Fizan-Feroz/ESP-FC-custom/pcb/v2/drc_report.txt

** Drc report for esp-fc-v2.kicad_pcb **
** Created on 2026-11-04T15:46:17 **
** Report includes: Errors, Warnings **

** Found 74 DRC violations **
[lib_footprint_issues]: The current configuration does not include the footprint library 'Resistor_SMD'
    Local override; warning
    @(107.5000 mm, 110.6000 mm): Footprint R9
[lib_footprint_issues]: The current configuration does not include the footprint library 'LED_SMD'
    Local override; warning
    @(107.5000 mm, 105.0000 mm): Footprint D3
[lib_footprint_issues]: The current configuration does not include the footprint library 'Resistor_SMD'
    Local override; warning
    @(107.5000 mm, 106.9000 mm): Footprint R8
[lib_footprint_issues]: The current configuration does not include the footprint library 'Connector_USB'
    Local override; warning
    @(86.3000 mm, 96.0000 mm): Footprint J2
[lib_footprint_issues]: The current configuration does not include the footprint library 'MountingHole'
    Local override; warning
    @(84.7500 mm, 115.2500 mm): Footprint H4
[lib_footprint_issues]: The current configuration does not include the footprint library 'Inductor_SMD'
    Local override; warning
    @(114.6000 mm, 91.4000 mm): Footprint L1
[lib_footprint_issues]: The current configuration does not include the footprint library 'Capacitor_SMD'
    Local override; warning
    @(115.9000 mm, 105.6000 mm): Footprint C2
[lib_footprint_issues]: The current configuration does not include the footprint library 'Diode_SMD'
    Local override; warning
    @(92.2000 mm, 108.0000 mm): Footprint D1
[lib_footprint_issues]: The current configuration does not include the footprint library 'Capacitor_SMD'
    Local override; warning
    @(89.7500 mm, 87.0000 mm): Footprint C11
[lib_footprint_issues]: The current configuration does not include the footprint library 'Package_TO_SOT_SMD'
    Local override; warning
    @(100.9000 mm, 107.4000 mm): Footprint U4
[lib_footprint_issues]: The current configuration does not include the footprint library 'Connector_JST'
    Local override; warning
    @(100.0000 mm, 114.5000 mm): Footprint J1
[lib_footprint_issues]: The current configuration does not include the footprint library 'TestPoint'
    Local override; warning
    @(85.0000 mm, 109.9000 mm): Footprint TP2
[lib_footprint_issues]: The current configuration does not include the footprint library 'Package_SO'
    Local override; warning
    @(114.6000 mm, 98.6000 mm): Footprint U1
[lib_footprint_issues]: The current configuration does not include the footprint library 'RF_Module'
    Local override; warning
    @(101.5000 mm, 93.2000 mm): Footprint U5
[lib_footprint_issues]: The current configuration does not include the footprint library 'Capacitor_SMD'
    Local override; warning
    @(89.7500 mm, 83.7500 mm): Footprint C12
[lib_footprint_issues]: The current configuration does not include the footprint library 'MountingHole'
    Local override; warning
    @(115.2500 mm, 84.7500 mm): Footprint H2
[lib_footprint_issues]: The current configuration does not include the footprint library 'MountingHole'
    Local override; warning
    @(84.7500 mm, 84.7500 mm): Footprint H1
[lib_footprint_issues]: The current configuration does not include the footprint library 'TestPoint'
    Local override; warning
    @(85.0000 mm, 106.0000 mm): Footprint TP1
[lib_footprint_issues]: The current configuration does not include the footprint library 'LED_SMD'
    Local override; warning
    @(107.5000 mm, 108.8000 mm): Footprint D4
[lib_footprint_issues]: The current configuration does not include the footprint library 'MountingHole'
    Local override; warning
    @(115.2500 mm, 115.2500 mm): Footprint H3
[lib_footprint_issues]: The current configuration does not include the footprint library 'Capacitor_SMD'
    Local override; warning
    @(112.9000 mm, 105.6000 mm): Footprint C1
[lib_footprint_issues]: The current configuration does not include the footprint library 'Capacitor_SMD'
    Local override; warning
    @(112.9000 mm, 91.2000 mm): Footprint C6
[lib_footprint_issues]: The current configuration does not include the footprint library 'Package_TO_SOT_SMD'
    Local override; warning
    @(109.6000 mm, 106.0000 mm): Footprint Q3
[lib_footprint_issues]: The current configuration does not include the footprint library 'Package_LGA'
    Local override; warning
    @(104.8000 mm, 99.0000 mm): Footprint U6
[lib_footprint_issues]: The current configuration does not include the footprint library 'TestPoint'
    Local override; warning
    @(116.3000 mm, 109.6000 mm): Footprint TP4
[lib_footprint_issues]: The current configuration does not include the footprint library 'Capacitor_SMD'
    Local override; warning
    @(100.0000 mm, 102.0000 mm): Footprint C17
[lib_footprint_issues]: The current configuration does not include the footprint library 'Resistor_SMD'
    Local override; warning
    @(109.8000 mm, 103.0000 mm): Footprint R2
[lib_footprint_issues]: The current configuration does not include the footprint library 'Package_TO_SOT_SMD'
    Local override; warning
    @(93.0000 mm, 104.5000 mm): Footprint Q1
[lib_footprint_issues]: The current configuration does not include the footprint library 'Resistor_SMD'
    Local override; warning
    @(109.4000 mm, 89.7000 mm): Footprint R12
[lib_footprint_issues]: The current configuration does not include the footprint library 'Diode_SMD'
    Local override; warning
    @(114.6000 mm, 106.6000 mm): Footprint D5
[lib_footprint_issues]: The current configuration does not include the footprint library 'Capacitor_SMD'
    Local override; warning
    @(102.3000 mm, 108.5000 mm): Footprint C9
[lib_footprint_issues]: The current configuration does not include the footprint library 'Package_TO_SOT_SMD'
    Local override; warning
    @(88.5000 mm, 103.2000 mm): Footprint U2
[lib_footprint_issues]: The current configuration does not include the footprint library 'Resistor_SMD'
    Local override; warning
    @(106.3000 mm, 111.0000 mm): Footprint R16
[lib_footprint_issues]: The current configuration does not include the footprint library 'Capacitor_SMD'
    Local override; warning
    @(114.6000 mm, 103.5000 mm): Footprint C3
[lib_footprint_issues]: The current configuration does not include the footprint library 'Resistor_SMD'
    Local override; warning
    @(103.2000 mm, 89.7000 mm): Footprint R10
[lib_footprint_issues]: The current configuration does not include the footprint library 'Inductor_SMD'
    Local override; warning
    @(107.4000 mm, 102.4000 mm): Footprint FB1
[lib_footprint_issues]: The current configuration does not include the footprint library 'Resistor_SMD'
    Local override; warning
    @(93.0000 mm, 107.6000 mm): Footprint R5
[lib_footprint_issues]: The current configuration does not include the footprint library 'Capacitor_SMD'
    Local override; warning
    @(104.8000 mm, 96.3500 mm): Footprint C14
[lib_footprint_issues]: The current configuration does not include the footprint library 'Resistor_SMD'
    Local override; warning
    @(84.0000 mm, 102.5000 mm): Footprint R3
[lib_footprint_issues]: The current configuration does not include the footprint library 'Button_Switch_SMD'
    Local override; warning
    @(101.0000 mm, 115.5000 mm): Footprint SW2
[lib_footprint_issues]: The current configuration does not include the footprint library 'Resistor_SMD'
    Local override; warning
    @(84.0000 mm, 106.4000 mm): Footprint R4
[lib_footprint_issues]: The current configuration does not include the footprint library 'Capacitor_SMD'
    Local override; warning
    @(102.6000 mm, 104.0000 mm): Footprint C18
[lib_footprint_issues]: The current configuration does not include the footprint library 'Capacitor_SMD'
    Local override; warning
    @(106.0000 mm, 108.5000 mm): Footprint C10
[lib_footprint_issues]: The current configuration does not include the footprint library 'Capacitor_SMD'
    Local override; warning
    @(107.4000 mm, 99.0000 mm): Footprint C16
[lib_footprint_issues]: The current configuration does not include the footprint library 'TestPoint'
    Local override; warning
    @(113.5000 mm, 109.6000 mm): Footprint TP3
[lib_footprint_issues]: The current configuration does not include the footprint library 'Resistor_SMD'
    Local override; warning
    @(100.0000 mm, 96.0000 mm): Footprint R17
[lib_footprint_issues]: The current configuration does not include the footprint library 'Capacitor_SMD'
    Local override; warning
    @(96.6000 mm, 89.7000 mm): Footprint C8
[lib_footprint_issues]: The current configuration does not include the footprint library 'Resistor_SMD'
    Local override; warning
    @(109.6000 mm, 109.0000 mm): Footprint R15
[lib_footprint_issues]: The current configuration does not include the footprint library 'Package_SO'
    Local override; warning
    @(94.5000 mm, 97.5000 mm): Footprint U3
[lib_footprint_issues]: The current configuration does not include the footprint library 'Diode_SMD'
    Local override; warning
    @(88.3000 mm, 106.6000 mm): Footprint D2
[lib_footprint_issues]: The current configuration does not include the footprint library 'Package_TO_SOT_SMD'
    Local override; warning
    @(97.2000 mm, 104.5000 mm): Footprint Q2
[lib_footprint_issues]: The current configuration does not include the footprint library 'Capacitor_SMD'
    Local override; warning
    @(93.4000 mm, 89.7000 mm): Footprint C13
[lib_footprint_issues]: The current configuration does not include the footprint library 'Button_Switch_SMD'
    Local override; warning
    @(95.0000 mm, 115.5000 mm): Footprint SW1
[lib_footprint_issues]: The current configuration does not include the footprint library 'Capacitor_SMD'
    Local override; warning
    @(104.8000 mm, 101.6500 mm): Footprint C15
[lib_footprint_issues]: The current configuration does not include the footprint library 'Resistor_SMD'
    Local override; warning
    @(100.0000 mm, 98.0000 mm): Footprint R13
[lib_footprint_issues]: The current configuration does not include the footprint library 'Connector_JST'
    Local override; warning
    @(105.0000 mm, 85.6000 mm): Footprint J3
[lib_footprint_issues]: The current configuration does not include the footprint library 'Capacitor_SMD'
    Local override; warning
    @(115.9000 mm, 91.2000 mm): Footprint C7
[lib_footprint_issues]: The current configuration does not include the footprint library 'Capacitor_SMD'
    Local override; warning
    @(109.8000 mm, 95.0000 mm): Footprint C5
[lib_footprint_issues]: The current configuration does not include the footprint library 'Resistor_SMD'
    Local override; warning
    @(100.0000 mm, 100.0000 mm): Footprint R14
[lib_footprint_issues]: The current configuration does not include the footprint library 'Resistor_SMD'
    Local override; warning
    @(106.3000 mm, 89.7000 mm): Footprint R11
[lib_footprint_issues]: The current configuration does not include the footprint library 'Capacitor_SMD'
    Local override; warning
    @(109.8000 mm, 97.0000 mm): Footprint C4
[lib_footprint_issues]: The current configuration does not include the footprint library 'Resistor_SMD'
    Local override; warning
    @(90.4000 mm, 89.7000 mm): Footprint R7
[lib_footprint_issues]: The current configuration does not include the footprint library 'TestPoint'
    Local override; warning
    @(109.6000 mm, 112.6000 mm): Footprint TP5
[lib_footprint_issues]: The current configuration does not include the footprint library 'Resistor_SMD'
    Local override; warning
    @(109.8000 mm, 101.0000 mm): Footprint R1
[lib_footprint_issues]: The current configuration does not include the footprint library 'Resistor_SMD'
    Local override; warning
    @(97.2000 mm, 107.6000 mm): Footprint R6
[lib_footprint_issues]: The current configuration does not include the footprint library 'Connector_JST'
    Local override; warning
    @(94.2000 mm, 85.6000 mm): Footprint J4
[silk_overlap]: Silkscreen clearance
    Rule: board setup constraints silk; warning
    @(100.0000 mm, 110.5200 mm): Reference field of J1
    @(99.0500 mm, 110.8100 mm): Segment of U4 on F.Silkscreen
[silk_over_copper]: Silkscreen clipped by solder mask
    Local override; warning
    @(100.9000 mm, 102.9000 mm): Reference field of U4
    @(100.8650 mm, 102.5500 mm): Pad 19 [<no net>] of U5 on F.Cu
[silk_over_copper]: Silkscreen clipped by solder mask
    Local override; warning
    @(111.1000 mm, 98.6000 mm): Reference field of U1
    @(110.2500 mm, 98.7600 mm): Pad 27 [UART2_RX] of U5 on F.Cu
[silk_over_copper]: Silkscreen clipped by solder mask
    Local override; warning
    @(91.9450 mm, 96.0000 mm): Reference field of J2
    @(92.7500 mm, 96.2200 mm): Pad 10 [M2] of U5 on F.Cu
[silk_over_copper]: Silkscreen clipped by solder mask
    Local override; warning
    @(105.0000 mm, 89.5800 mm): Reference field of J3
    @(104.0250 mm, 89.7000 mm): Pad 1 [+3V3] of R10 on B.Cu
[silk_over_copper]: Silkscreen clipped by solder mask
    Local override; warning
    @(105.0000 mm, 89.5800 mm): Reference field of J3
    @(105.4750 mm, 89.7000 mm): Pad 2 [I2C_SDA] of R11 on B.Cu
[silk_over_copper]: Silkscreen clipped by solder mask
    Local override; warning
    @(94.2000 mm, 89.5800 mm): Reference field of J4
    @(94.1750 mm, 89.7000 mm): Pad 1 [EN] of C13 on B.Cu
[silk_over_copper]: Silkscreen clipped by solder mask
    Local override; warning
    @(88.5000 mm, 100.8000 mm): Reference field of U2
    @(89.4300 mm, 100.3200 mm): PTH pad SH [GND] of J2

** Found 0 unconnected pads **

** Found 0 Footprint errors **

** Ignored checks **
    - Footprint has no courtyard defined
    - Track endpoint not centered on via
    - Tuning profile track geometries
    - Footprint doesn't match symbol's footprint filters
    - Footprint component type doesn't match footprint pads

** End of Report **
