Fizan-Feroz/ESP-FC-custom/pcb/v2/erc_report.txt

ERC report (2026-11-04T15:46:17, Encoding UTF8)
Report includes: Errors, Warnings

***** Sheet /
[footprint_link_issues]: The current configuration does not include the footprint library 'Inductor_SMD'
    ; warning
    @(30.48 mm, 74.93 mm): Symbol L1 [L]
[lib_symbol_issues]: The current configuration does not include the symbol library 'Device'
    ; warning
    @(30.48 mm, 74.93 mm): Symbol L1 [L]
[footprint_link_issues]: The current configuration does not include the footprint library 'Resistor_SMD'
    ; warning
    @(30.48 mm, 190.50 mm): Symbol R6 [R]
[lib_symbol_issues]: The current configuration does not include the symbol library 'Device'
    ; warning
    @(30.48 mm, 190.50 mm): Symbol R6 [R]
[footprint_link_issues]: The current configuration does not include the footprint library 'Package_TO_SOT_SMD'
    ; warning
    @(30.48 mm, 270.51 mm): Symbol U4 [AP7361C-33E]
[lib_symbol_issues]: The current configuration does not include the symbol library 'Regulator_Linear'
    ; warning
    @(30.48 mm, 270.51 mm): Symbol U4 [AP7361C-33E]
[footprint_link_issues]: The current configuration does not include the footprint library 'LED_SMD'
    ; warning
    @(30.48 mm, 304.80 mm): Symbol D3 [LED]
[lib_symbol_issues]: The current configuration does not include the symbol library 'Device'
    ; warning
    @(30.48 mm, 304.80 mm): Symbol D3 [LED]
[footprint_link_issues]: The current configuration does not include the footprint library 'Capacitor_SMD'
    ; warning
    @(30.48 mm, 420.37 mm): Symbol C18 [C]
[lib_symbol_issues]: The current configuration does not include the symbol library 'Device'
    ; warning
    @(30.48 mm, 420.37 mm): Symbol C18 [C]
[lib_symbol_issues]: The current configuration does not include the symbol library 'power'
    ; warning
    @(30.48 mm, 454.66 mm): Symbol #FLG03 [PWR_FLAG]
[footprint_link_issues]: The current configuration does not include the footprint library 'Connector_JST'
    ; warning
    @(49.53 mm, 59.69 mm): Symbol J1 [Conn_01x08_MountingPin]
[lib_symbol_issues]: The current configuration does not include the symbol library 'Connector_Generic_MountingPin'
    ; warning
    @(49.53 mm, 59.69 mm): Symbol J1 [Conn_01x08_MountingPin]
[footprint_link_issues]: The current configuration does not include the footprint library 'Connector_USB'
    ; warning
    @(49.53 mm, 175.26 mm): Symbol J2 [USB_C_Receptacle_USB2.0_16P]
[lib_symbol_issues]: The current configuration does not include the symbol library 'Connector'
    ; warning
    @(49.53 mm, 175.26 mm): Symbol J2 [USB_C_Receptacle_USB2.0_16P]
[footprint_link_issues]: The current configuration does not include the footprint library 'Package_LGA'
    ; warning
    @(49.53 mm, 405.13 mm): Symbol U6 [ICM-42688-P]
[footprint_link_issues]: The current configuration does not include the footprint library 'Resistor_SMD'
    ; warning
    @(59.69 mm, 74.93 mm): Symbol R1 [R]
[lib_symbol_issues]: The current configuration does not include the symbol library 'Device'
    ; warning
    @(59.69 mm, 74.93 mm): Symbol R1 [R]
[footprint_link_issues]: The current configuration does not include the footprint library 'Capacitor_SMD'
    ; warning
    @(59.69 mm, 270.51 mm): Symbol C9 [C]
[lib_symbol_issues]: The current configuration does not include the symbol library 'Device'
    ; warning
    @(59.69 mm, 270.51 mm): Symbol C9 [C]
[footprint_link_issues]: The current configuration does not include the footprint library 'Resistor_SMD'
    ; warning
    @(59.69 mm, 304.80 mm): Symbol R9 [R]
[lib_symbol_issues]: The current configuration does not include the symbol library 'Device'
    ; warning
    @(59.69 mm, 304.80 mm): Symbol R9 [R]
[footprint_link_issues]: The current configuration does not include the footprint library 'Package_TO_SOT_SMD'
    ; warning
    @(59.69 mm, 420.37 mm): Symbol Q3 [2N7002]
[lib_symbol_issues]: The current configuration does not include the symbol library 'Transistor_FET'
    ; warning
    @(59.69 mm, 420.37 mm): Symbol Q3 [2N7002]
[lib_symbol_issues]: The current configuration does not include the symbol library 'power'
    ; warning
    @(59.69 mm, 454.66 mm): Symbol #FLG04 [PWR_FLAG]
[footprint_link_issues]: The current configuration does not include the footprint library 'Resistor_SMD'
    ; warning
    @(90.17 mm, 74.93 mm): Symbol R2 [R]
[lib_symbol_issues]: The current configuration does not include the symbol library 'Device'
    ; warning
    @(90.17 mm, 74.93 mm): Symbol R2 [R]
[footprint_link_issues]: The current configuration does not include the footprint library 'Capacitor_SMD'
    ; warning
    @(90.17 mm, 270.51 mm): Symbol C10 [C]
[lib_symbol_issues]: The current configuration does not include the symbol library 'Device'
    ; warning
    @(90.17 mm, 270.51 mm): Symbol C10 [C]
[footprint_link_issues]: The current configuration does not include the footprint library 'LED_SMD'
    ; warning
    @(90.17 mm, 304.80 mm): Symbol D4 [LED]
[lib_symbol_issues]: The current configuration does not include the symbol library 'Device'
    ; warning
    @(90.17 mm, 304.80 mm): Symbol D4 [LED]
[footprint_link_issues]: The current configuration does not include the footprint library 'Resistor_SMD'
    ; warning
    @(90.17 mm, 420.37 mm): Symbol R15 [R]
[lib_symbol_issues]: The current configuration does not include the symbol library 'Device'
    ; warning
    @(90.17 mm, 420.37 mm): Symbol R15 [R]
[footprint_link_issues]: The current configuration does not include the footprint library 'MountingHole'
    ; warning
    @(90.17 mm, 454.66 mm): Symbol H1 [MountingHole]
[lib_symbol_issues]: The current configuration does not include the symbol library 'Mechanical'
    ; warning
    @(90.17 mm, 454.66 mm): Symbol H1 [MountingHole]
[footprint_link_issues]: The current configuration does not include the footprint library 'TestPoint'
    ; warning
    @(100.33 mm, 39.37 mm): Symbol TP1 [TestPoint]
[lib_symbol_issues]: The current configuration does not include the symbol library 'Connector'
    ; warning
    @(100.33 mm, 39.37 mm): Symbol TP1 [TestPoint]
[footprint_link_issues]: The current configuration does not include the footprint library 'Resistor_SMD'
    ; warning
    @(100.33 mm, 154.94 mm): Symbol R3 [R]
[lib_symbol_issues]: The current configuration does not include the symbol library 'Device'
    ; warning
    @(100.33 mm, 154.94 mm): Symbol R3 [R]
[footprint_link_issues]: The current configuration does not include the footprint library 'Inductor_SMD'
    ; warning
    @(100.33 mm, 384.81 mm): Symbol FB1 [FerriteBead]
[lib_symbol_issues]: The current configuration does not include the symbol library 'Device'
    ; warning
    @(100.33 mm, 384.81 mm): Symbol FB1 [FerriteBead]
[footprint_link_issues]: The current configuration does not include the footprint library 'Capacitor_SMD'
    ; warning
    @(119.38 mm, 74.93 mm): Symbol C6 [C]
[lib_symbol_issues]: The current configuration does not include the symbol library 'Device'
    ; warning
    @(119.38 mm, 74.93 mm): Symbol C6 [C]
[footprint_link_issues]: The current configuration does not include the footprint library 'Capacitor_SMD'
    ; warning
    @(119.38 mm, 270.51 mm): Symbol C11 [C]
[lib_symbol_issues]: The current configuration does not include the symbol library 'Device'
    ; warning
    @(119.38 mm, 270.51 mm): Symbol C11 [C]
[footprint_link_issues]: The current configuration does not include the footprint library 'Diode_SMD'
    ; warning
    @(119.38 mm, 420.37 mm): Symbol D5 [D]
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
    ; warning
    @(180.34 mm, 454.66 mm): Symbol H4 [MountingHole]
[lib_symbol_issues]: The current configuration does not include the symbol library 'Mechanical'
    ; warning
    @(180.34 mm, 454.66 mm): Symbol H4 [MountingHole]
[footprint_link_issues]: The current configuration does not include the footprint library 'Capacitor_SMD'
    ; warning
    @(190.50 mm, 39.37 mm): Symbol C1 [C]
[lib_symbol_issues]: The current configuration does not include the symbol library 'Device'
    ; warning
    @(190.50 mm, 39.37 mm): Symbol C1 [C]
[footprint_link_issues]: The current configuration does not include the footprint library 'Diode_SMD'
    ; warning
    @(190.50 mm, 154.94 mm): Symbol D2 [D_Schottky]
[lib_symbol_issues]: The current configuration does not include the symbol library 'Device'
    ; warning
    @(190.50 mm, 154.94 mm): Symbol D2 [D_Schottky]
[footprint_link_issues]: The current configuration does not include the footprint library 'Capacitor_SMD'
    ; warning
    @(190.50 mm, 384.81 mm): Symbol C16 [C]
[lib_symbol_issues]: The current configuration does not include the symbol library 'Device'
    ; warning
    @(190.50 mm, 384.81 mm): Symbol C16 [C]
[footprint_link_issues]: The current configuration does not include the footprint library 'RF_Module'
    ; warning
    @(199.39 mm, 289.56 mm): Symbol U5 [ESP32-WROOM-32UE]
[lib_symbol_issues]: The current configuration does not include the symbol library 'RF_Module'
    ; warning
    @(199.39 mm, 289.56 mm): Symbol U5 [ESP32-WROOM-32UE]
[footprint_link_issues]: The current configuration does not include the footprint library 'Resistor_SMD'
    ; warning
    @(209.55 mm, 420.37 mm): Symbol R16 [R]
[lib_symbol_issues]: The current configuration does not include the symbol library 'Device'
    ; warning
    @(209.55 mm, 420.37 mm): Symbol R16 [R]
[footprint_link_issues]: The current configuration does not include the footprint library 'Capacitor_SMD'
    ; warning
    @(219.71 mm, 39.37 mm): Symbol C2 [C]
[lib_symbol_issues]: The current configuration does not include the symbol library 'Device'
    ; warning
    @(219.71 mm, 39.37 mm): Symbol C2 [C]
[footprint_link_issues]: The current configuration does not include the footprint library 'Resistor_SMD'
    ; warning
    @(219.71 mm, 384.81 mm): Symbol R10 [R]
[lib_symbol_issues]: The current configuration does not include the symbol library 'Device'
    ; warning
    @(219.71 mm, 384.81 mm): Symbol R10 [R]
[footprint_link_issues]: The current configuration does not include the footprint library 'Package_SO'
    ; warning
    @(240.03 mm, 175.26 mm): Symbol U3 [CH340C]
[lib_symbol_issues]: The current configuration does not include the symbol library 'Interface_USB'
    ; warning
    @(240.03 mm, 175.26 mm): Symbol U3 [CH340C]
[footprint_link_issues]: The current configuration does not include the footprint library 'TestPoint'
    ; warning
    @(240.03 mm, 420.37 mm): Symbol TP5 [TestPoint]
[lib_symbol_issues]: The current configuration does not include the symbol library 'Connector'
    ; warning
    @(240.03 mm, 420.37 mm): Symbol TP5 [TestPoint]
[footprint_link_issues]: The current configuration does not include the footprint library 'Capacitor_SMD'
    ; warning
    @(250.19 mm, 39.37 mm): Symbol C3 [C]
[lib_symbol_issues]: The current configuration does not include the symbol library 'Device'
    ; warning
    @(250.19 mm, 39.37 mm): Symbol C3 [C]
[footprint_link_issues]: The current configuration does not include the footprint library 'Resistor_SMD'
    ; warning
    @(250.19 mm, 270.51 mm): Symbol R7 [R]
[lib_symbol_issues]: The current configuration does not include the symbol library 'Device'
    ; warning
    @(250.19 mm, 270.51 mm): Symbol R7 [R]
[footprint_link_issues]: The current configuration does not include the footprint library 'Resistor_SMD'
    ; warning
    @(250.19 mm, 384.81 mm): Symbol R11 [R]
[lib_symbol_issues]: The current configuration does not include the symbol library 'Device'
    ; warning
    @(250.19 mm, 384.81 mm): Symbol R11 [R]
[footprint_link_issues]: The current configuration does not include the footprint library 'Connector_JST'
    ; warning
    @(270.51 mm, 420.37 mm): Symbol J3 [Conn_01x04_MountingPin]
[lib_symbol_issues]: The current configuration does not include the symbol library 'Connector_Generic_MountingPin'
    ; warning
    @(270.51 mm, 420.37 mm): Symbol J3 [Conn_01x04_MountingPin]
[footprint_link_issues]: The current configuration does not include the footprint library 'Capacitor_SMD'
    ; warning
    @(279.40 mm, 270.51 mm): Symbol C13 [C]
[lib_symbol_issues]: The current configuration does not include the symbol library 'Device'
    ; warning
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
    ; warning
    @(369.57 mm, 270.51 mm): Symbol R8 [R]
[footprint_link_issues]: The current configuration does not include the footprint library 'Capacitor_SMD'
    ; warning
    @(369.57 mm, 384.81 mm): Symbol C17 [C]
[lib_symbol_issues]: The current configuration does not include the symbol library 'Device'
    ; warning
    @(369.57 mm, 384.81 mm): Symbol C17 [C]
[footprint_link_issues]: The current configuration does not include the footprint library 'Capacitor_SMD'
    ; warning
    @(379.73 mm, 39.37 mm): Symbol C5 [C]
[lib_symbol_issues]: The current configuration does not include the symbol library 'Device'
    ; warning
    @(379.73 mm, 39.37 mm): Symbol C5 [C]
[footprint_link_issues]: The current configuration does not include the footprint library 'Package_TO_SOT_SMD'
    ; warning
    @(379.73 mm, 154.94 mm): Symbol Q2 [MMBT3904]
[lib_symbol_issues]: The current configuration does not include the symbol library 'Transistor_BJT'
    ; warning
    @(379.73 mm, 154.94 mm): Symbol Q2 [MMBT3904]
[footprint_link_issues]: The current configuration does not include the footprint library 'Resistor_SMD'
    ; warning
    @(400.05 mm, 175.26 mm): Symbol R17 [R]
[lib_symbol_issues]: The current configuration does not include the symbol library 'Device'
    ; warning
    @(400.05 mm, 175.26 mm): Symbol R17 [R]
[lib_symbol_issues]: The current configuration does not include the symbol library 'power'
    ; warning
    @(430.53 mm, 175.26 mm): Symbol #FLG05 [PWR_FLAG]

 ** ERC messages: 136  Errors 0  Warnings 136

 ** Ignored checks:
    - Global label only appears once in the schematic
    - Four connection points are joined together
    - SPICE model issue
    - Assigned footprint doesn't match footprint filters
