Fizan-Feroz/ESP-FC-custom/pcb/esp32_fc_bottom_render.png

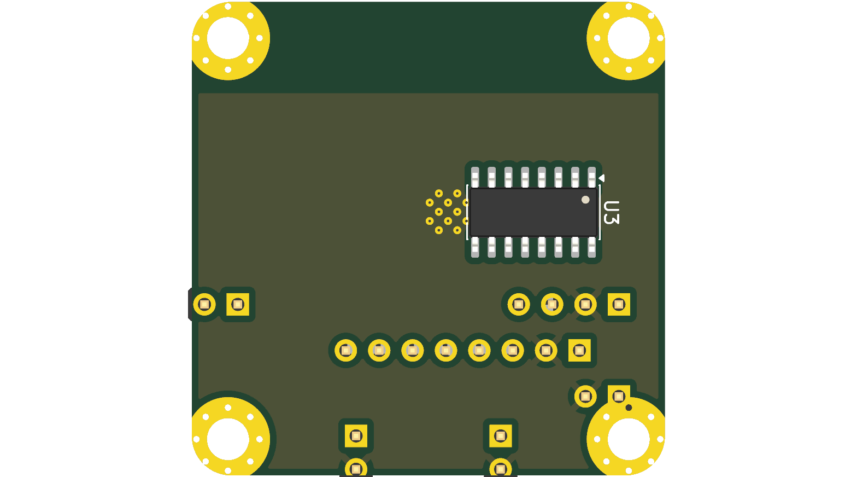
pcb/esp32_fc_bottom_render.png
