Fizan-Feroz/ESP-FC-custom/pcb/esp32_fc_top_render.png

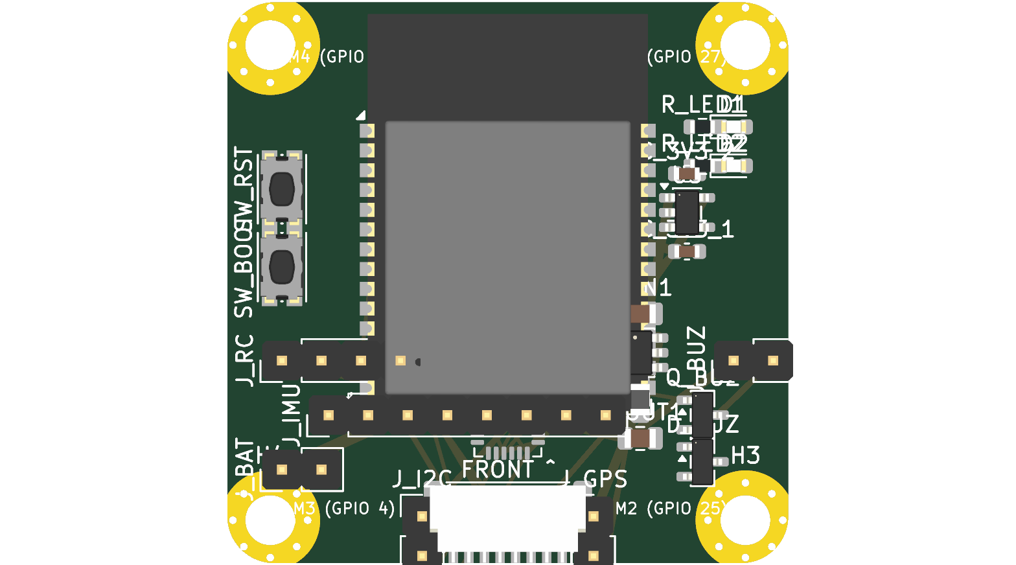
pcb/esp32_fc_top_render.png
