Fizan-Feroz/ESP-FC-custom/pcb/v2/v2_placement_top.png

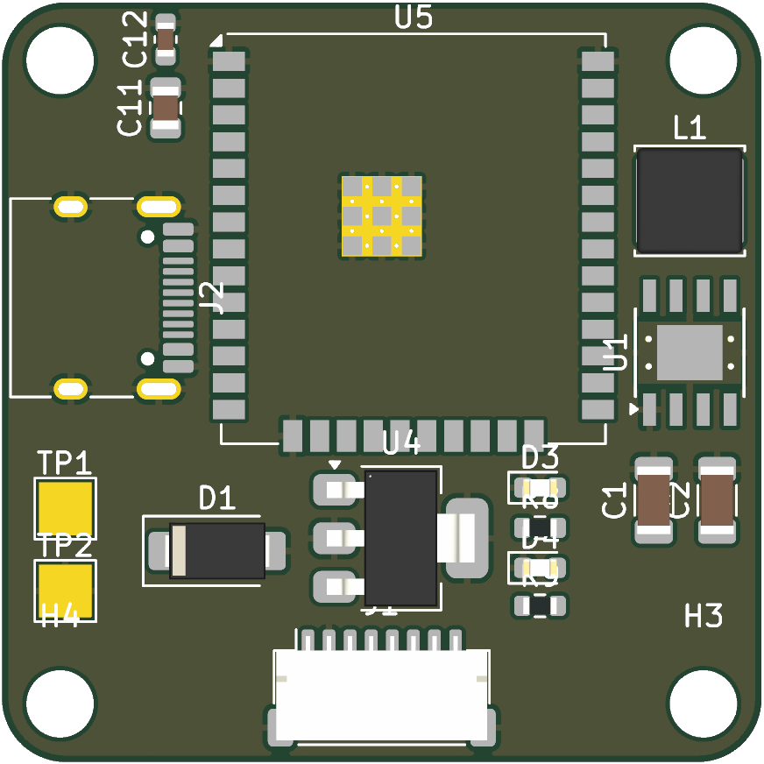
pcb/v2/v2_placement_top.png
