Fizan-Feroz/ESP-FC-custom/pcb/v2/esp-fc-v2.kicad_pcb

## KiCad design pcb/v2/esp-fc-v2.kicad_pcb (2026-11-04)

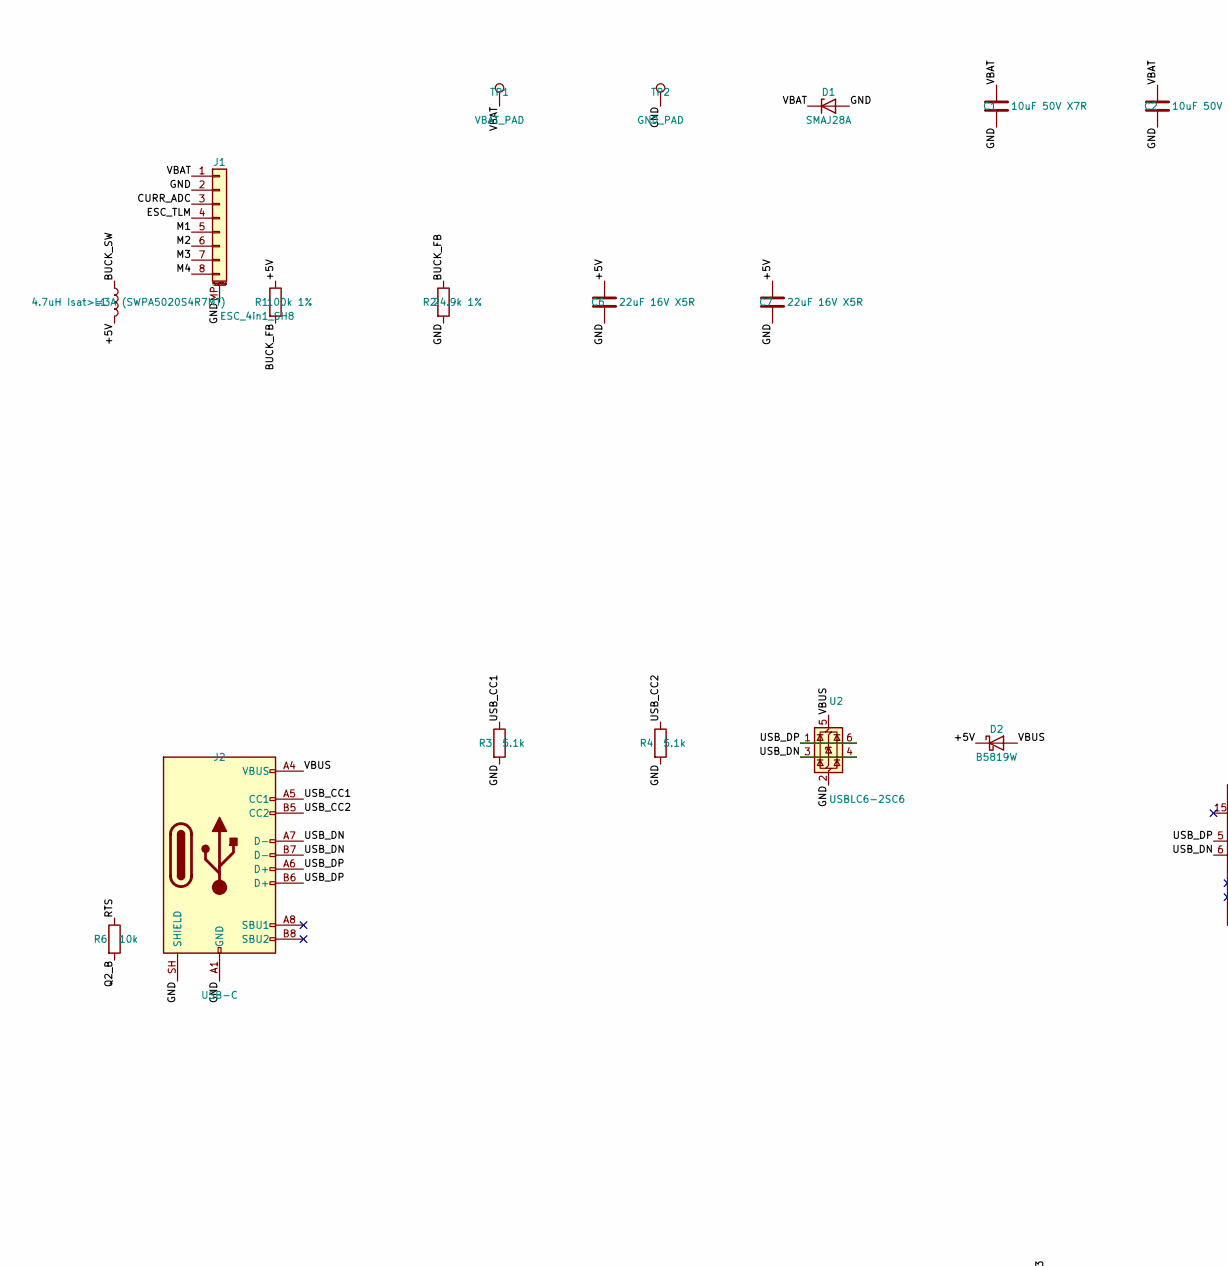
[picture p4: schematic esp-fc-v2.kicad_sch, part in row 1, column 1]

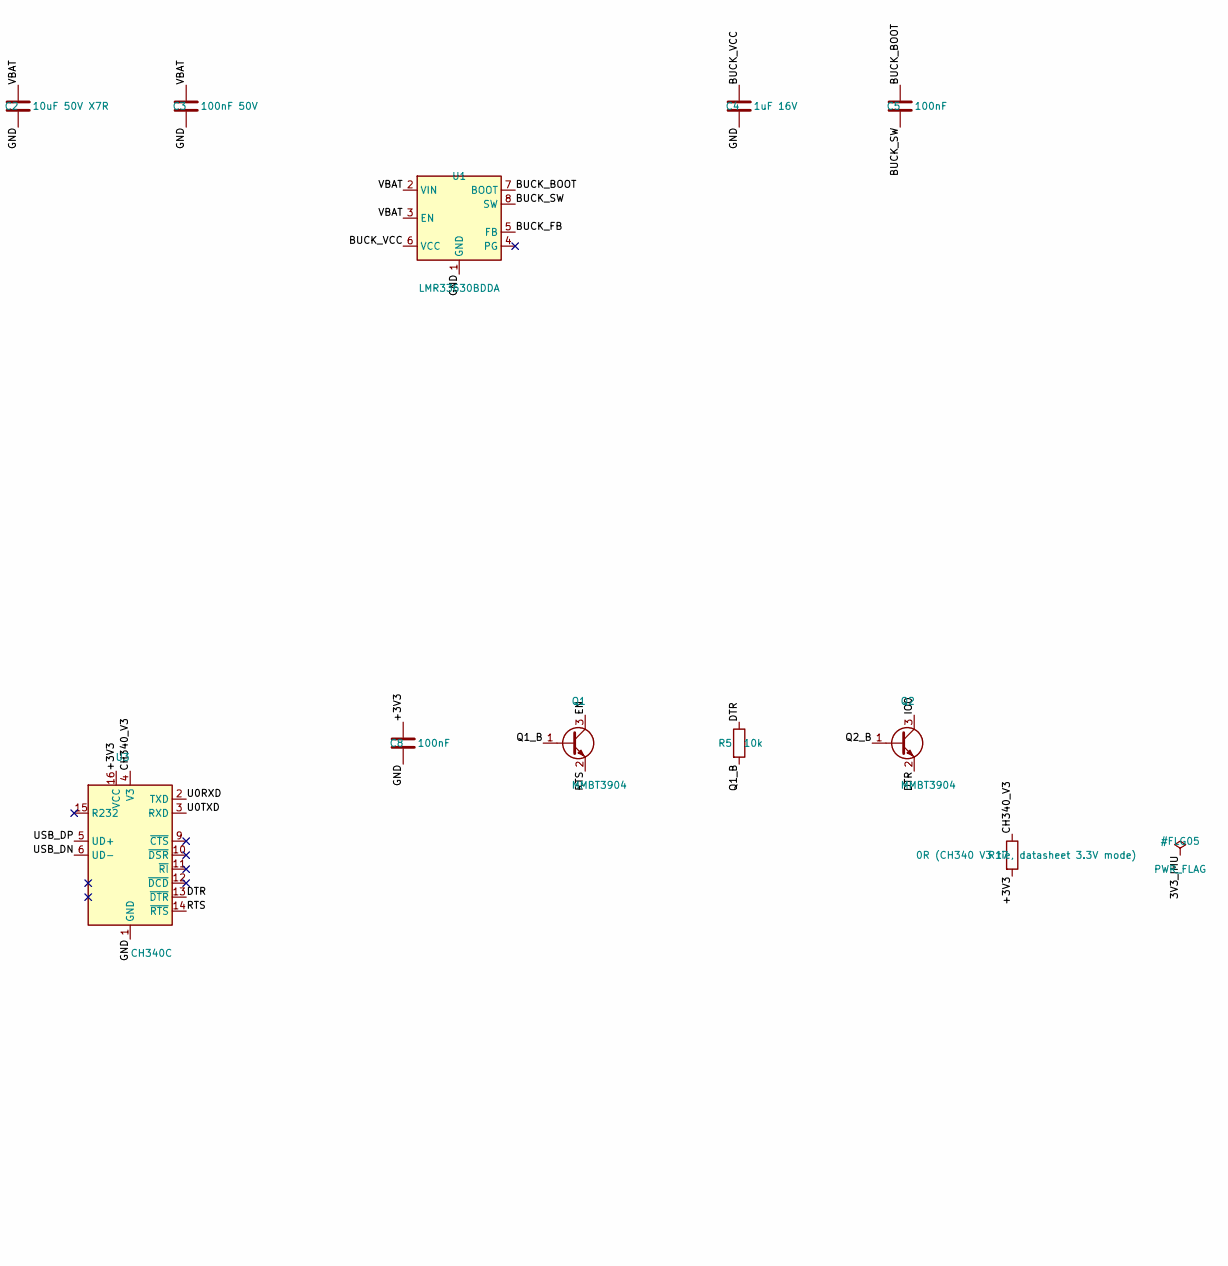
[picture p5: schematic esp-fc-v2.kicad_sch, part in row 1, column 2]

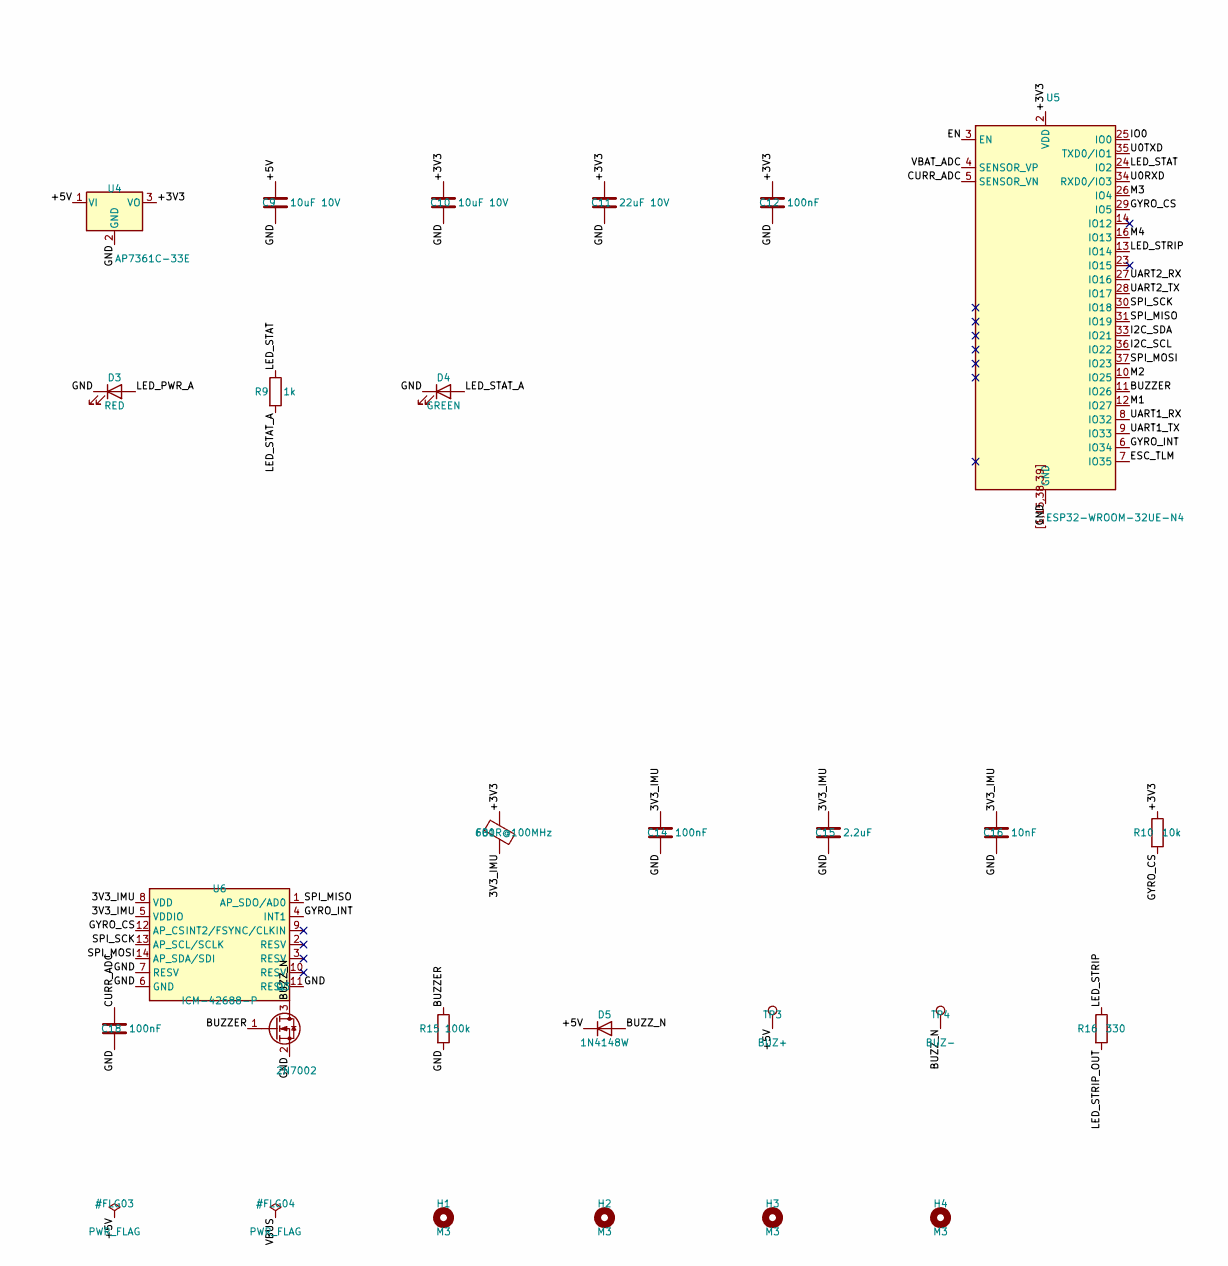
[picture p6: schematic esp-fc-v2.kicad_sch, part in row 2, column 1]

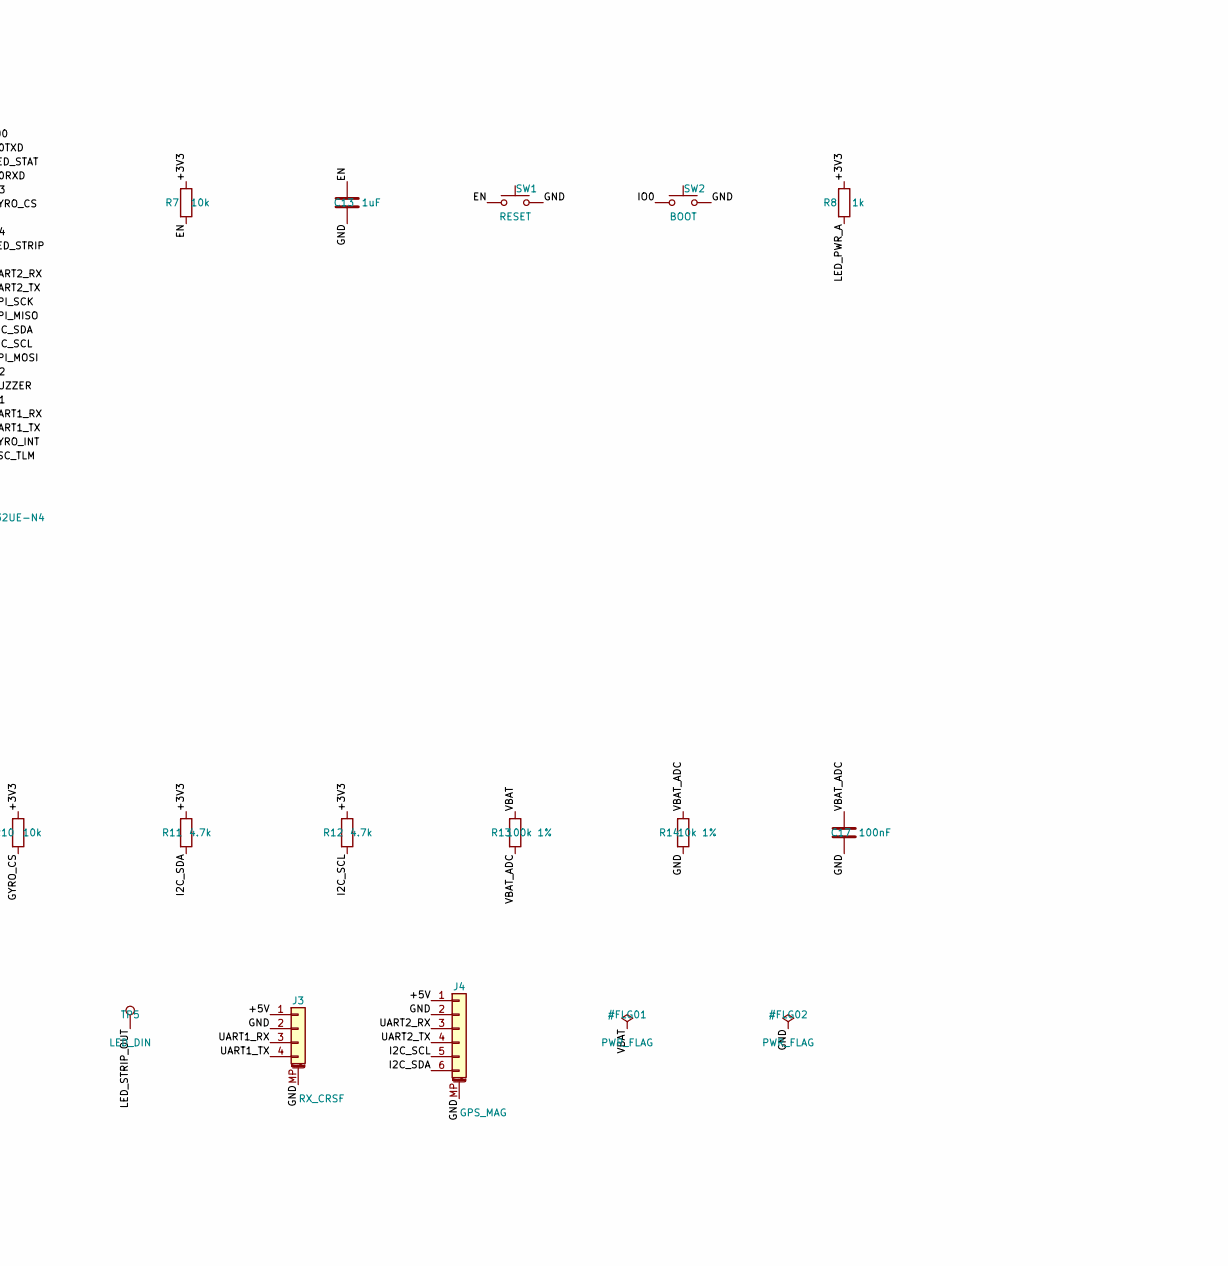
[picture p7: schematic esp-fc-v2.kicad_sch, part in row 2, column 2]

Parts:
C1, C2: 10uF 50V X7R; C_1206_3216Metric
C3: 100nF 50V; C_0603_1608Metric
C4: 1uF 16V; C_0603_1608Metric
C5, C8, C12, C14, C17, C18: 100nF; C_0603_1608Metric
C6, C7: 22uF 16V X5R; C_1206_3216Metric
C9, C10: 10uF 10V; C_0805_2012Metric
C11: 22uF 10V; C_0805_2012Metric
C13: 1uF; C_0603_1608Metric
C15: 2.2uF; C_0603_1608Metric
C16: 10nF; C_0603_1608Metric
D1: SMAJ28A; D_SMA
D2: B5819W; D_SOD-123
D3: RED; LED_0603_1608Metric
D4: GREEN; LED_0603_1608Metric
D5: 1N4148W; D_SOD-323
FB1: 600R@100MHz; L_0603_1608Metric
H1, H2, H3, H4: M3; MountingHole_3.2mm_M3
J1: ESC_4in1_SH8; JST_SH_SM08B-SRSS-TB_1x08-1MP_P1.00mm_Horizontal
J2: USB-C; USB_C_Receptacle_HRO_TYPE-C-31-M-12
J3: RX_CRSF; JST_SH_SM04B-SRSS-TB_1x04-1MP_P1.00mm_Horizontal
J4: GPS_MAG; JST_SH_SM06B-SRSS-TB_1x06-1MP_P1.00mm_Horizontal
L1: 4.7uH Isat>=3A (SWPA5020S4R7MT); L_Sunlord_SWPA5020S
Q1, Q2: MMBT3904; SOT-23
Q3: 2N7002; SOT-23
R1, R13: 100k 1%; R_0603_1608Metric
R2: 24.9k 1%; R_0603_1608Metric
R3, R4: 5.1k; R_0603_1608Metric
R5, R6, R7, R10: 10k; R_0603_1608Metric
R8, R9: 1k; R_0603_1608Metric
R11, R12: 4.7k; R_0603_1608Metric
R14: 10k 1%; R_0603_1608Metric
R15: 100k; R_0603_1608Metric
R16: 330; R_0603_1608Metric
R17: 0R (CH340 V3 tie, datasheet 3.3V mode); R_0603_1608Metric
SW1: RESET; SW_Push_1P1T_NO_CK_KMR2
SW2: BOOT; SW_Push_1P1T_NO_CK_KMR2
TP1: VBAT_PAD; TestPoint_Pad_2.5x2.5mm
TP2: GND_PAD; TestPoint_Pad_2.5x2.5mm
TP3: BUZ+; TestPoint_Pad_1.5x1.5mm
TP4: BUZ-; TestPoint_Pad_1.5x1.5mm
TP5: LED_DIN; TestPoint_Pad_1.5x1.5mm
U1: LMR33630BDDA; Texas_HSOP-8-1EP_3.9x4.9mm_P1.27mm_ThermalVias
U2: USBLC6-2SC6; SOT-23-6
U3: CH340C; SOIC-16_3.9x9.9mm_P1.27mm
U4: AP7361C-33E; SOT-223-3_TabPin2
U5: ESP32-WROOM-32UE-N4; ESP32-WROOM-32UE
U6: ICM-42688-P; LGA-14_3x2.5mm_P0.5mm_LayoutBorder3x4y

Connections:
3V3_IMU: C14.1, C15.1, C16.1, FB1.2, U6.5 (VDDIO), U6.8 (VDD)
+3V3: C8.1, C10.1, C11.1, C12.1, FB1.1, R7.1, R8.1, R10.1, R11.1, R12.1, R17.2, U3.16 (VCC), U4.3 (VO), U5.2 (VDD)
+5V: C6.1, C7.1, C9.1, D2.1 (K), D5.1 (K), J3.1, J4.1, L1.2, R1.1, TP3.1, U4.1 (VI)
BUCK_BOOT: C5.1, U1.7 (BOOT)
BUCK_FB: R1.2, R2.1, U1.5 (FB)
BUCK_SW: C5.2, L1.1, U1.8 (SW)
BUCK_VCC: C4.1, U1.6 (VCC)
BUZZER: Q3.1 (G), R15.1, U5.11 (IO26)
BUZZ_N: D5.2 (A), Q3.3 (D), TP4.1
CH340_V3: R17.1, U3.4 (V3)
CURR_ADC: C18.1, J1.3, U5.5 (SENSOR_VN)
DTR: Q2.2 (E), R5.1, U3.13 (~DTR)
EN: C13.1, Q1.3 (C), R7.2, SW1.1, U5.3 (EN)
ESC_TLM: J1.4, U5.7 (IO35)
GND: C1.2, C2.2, C3.2, C4.2, C6.2, C7.2, C8.2, C9.2, C10.2, C11.2, C12.2, C13.2, C14.2, C15.2, C16.2, C17.2, C18.2, D1.2 (A), D3.1 (K), D4.1 (K), J1.2, J1.MP (MountPin), J2.A1 (GND), J2.A12 (GND), J2.B1 (GND), J2.B12 (GND), J2.SH (SHIELD), J3.2, J3.MP (MountPin), J4.2, J4.MP (MountPin), Q3.2 (S), R2.2, R3.2, R4.2, R14.2, R15.2, SW1.2, SW2.2, TP2.1, U1.1 (GND), U1.9 (GND), U2.2 (GND), U3.1 (GND), U4.2 (GND), U5.1, U5.15, U5.38, U5.39, U5.[1,15,38,39] (GND), U6.6 (GND), U6.7 (RESV), U6.11 (RESV)
GYRO_CS: R10.2, U5.29 (IO5), U6.12 (AP_CS)
GYRO_INT: U5.6 (IO34), U6.4 (INT1)
I2C_SCL: J4.5, R12.2, U5.36 (IO22)
I2C_SDA: J4.6, R11.2, U5.33 (IO21)
IO0: Q2.3 (C), SW2.1, U5.25 (IO0)
LED_PWR_A: D3.2 (A), R8.2
LED_STAT: R9.1, U5.24 (IO2)
LED_STAT_A: D4.2 (A), R9.2
LED_STRIP: R16.1, U5.13 (IO14)
LED_STRIP_OUT: R16.2, TP5.1
M1: J1.5, U5.12 (IO27)
M2: J1.6, U5.10 (IO25)
M3: J1.7, U5.26 (IO4)
M4: J1.8, U5.16 (IO13)
Q1_B: Q1.1 (B), R5.2
Q2_B: Q2.1 (B), R6.2
RTS: Q1.2 (E), R6.1, U3.14 (~RTS)
SPI_MISO: U5.31 (IO19), U6.1 (AP_SDO/AD0)
SPI_MOSI: U5.37 (IO23), U6.14 (AP_SDA/SDI)
SPI_SCK: U5.30 (IO18), U6.13 (AP_SCL/SCLK)
U0RXD: U3.2 (TXD), U5.34 (RXD0/IO3)
U0TXD: U3.3 (RXD), U5.35 (TXD0/IO1)
UART1_RX: J3.3, U5.8 (IO32)
UART1_TX: J3.4, U5.9 (IO33)
UART2_RX: J4.3, U5.27 (IO16)
UART2_TX: J4.4, U5.28 (IO17)
USB_CC1: J2.A5 (CC1), R3.1
USB_CC2: J2.B5 (CC2), R4.1
USB_DN: J2.A7 (D-), J2.B7 (D-), U2.3 (I/O2), U2.4 (I/O2), U3.6 (UD-)
USB_DP: J2.A6 (D+), J2.B6 (D+), U2.1 (I/O1), U2.6 (I/O1), U3.5 (UD+)
VBAT: C1.1, C2.1, C3.1, D1.1 (K), J1.1, R13.1, TP1.1, U1.2 (VIN), U1.3 (EN)
VBAT_ADC: C17.1, R13.2, R14.1, U5.4 (SENSOR_VP)
VBUS: D2.2 (A), J2.A4 (VBUS), J2.A9 (VBUS), J2.B4 (VBUS), J2.B9 (VBUS), U2.5 (VBUS)

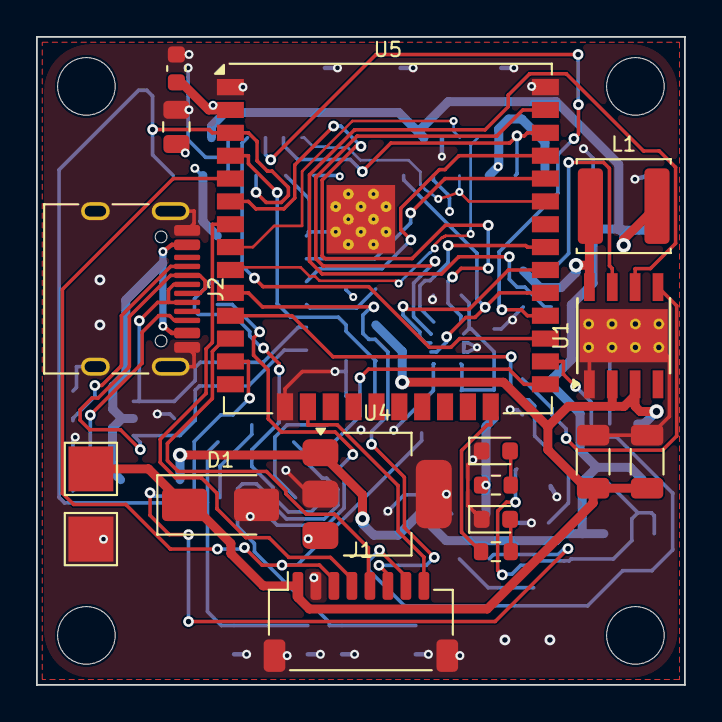
[picture p8: board esp-fc-v2.kicad_pcb from above]

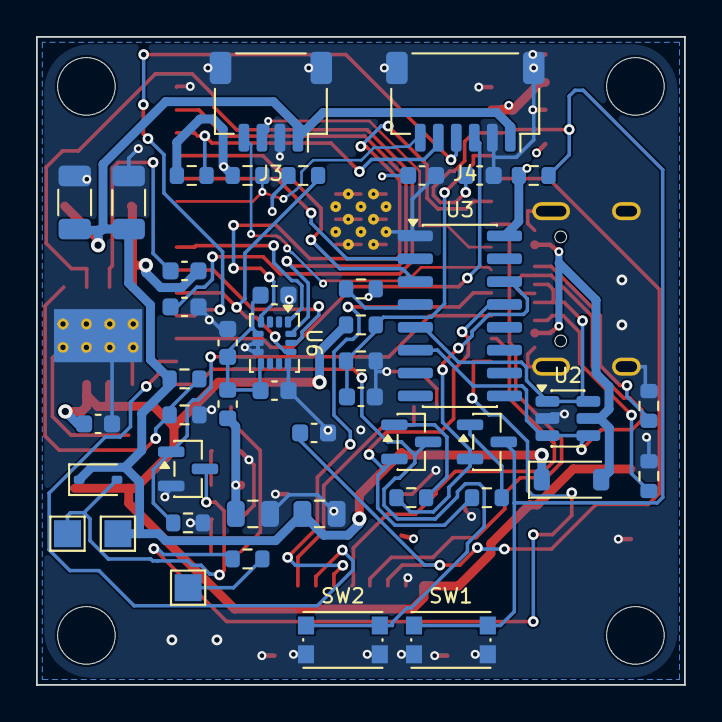
[picture p9: board esp-fc-v2.kicad_pcb from below]

Board: 4 copper layers, 36.0 x 36.0 mm, 66 parts (45 on the bottom side), 48 nets.
