Fizan-Feroz/ESP-FC-custom/pcb/esp32-fc.kicad_pcb

## KiCad design pcb/esp32-fc.kicad_pcb (2026-10-29)

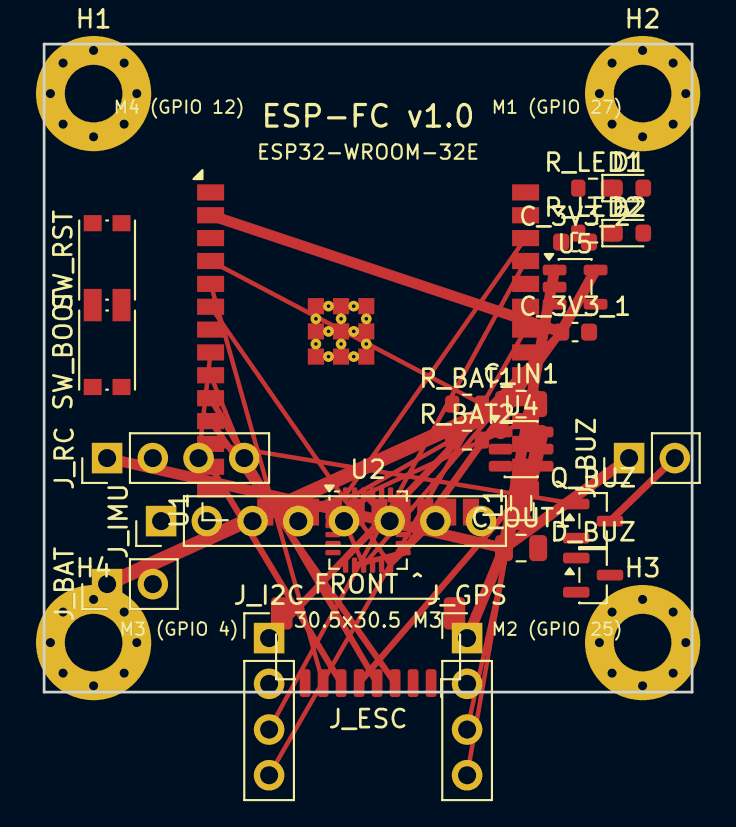
[picture p10: board esp32-fc.kicad_pcb from above]

Board: 4 copper layers, 36.0 x 36.0 mm, 31 parts (1 on the bottom side), 23 nets.

Parts:
C_3V3_1: 10uF; C_0603_1608Metric
C_3V3_2: 100nF; C_0603_1608Metric
C_IN1: 10uF_50V; C_0805_2012Metric
C_OUT1: 22uF_10V; C_0805_2012Metric
D1: LED_PWR_RED; LED_0603_1608Metric
D2: LED_STAT_GRN; LED_0603_1608Metric
D_BUZ: BAT54; SOT-23
H1, H2, H3, H4: M3_Mount; MountingHole_3.2mm_M3_Pad_Via
J_BAT: VBAT_2S-6S; PinHeader_1x02_P2.54mm_Vertical
J_BUZ: BUZZER; PinHeader_1x02_P2.54mm_Vertical
J_ESC: 4-IN-1_ESC; JST_SH_SM08B-SRSS-TB_1x08-1MP_P1.00mm_Horizontal
J_GPS: GPS_TELEM; PinHeader_1x04_P2.54mm_Vertical
J_I2C: I2C_BARO_MAG; PinHeader_1x04_P2.54mm_Vertical
J_IMU: IMU_Breakout; PinHeader_1x08_P2.54mm_Vertical
J_RC: ELRS_CRSF; PinHeader_1x04_P2.54mm_Vertical
L1: 4.7uH; L_0805_2012Metric
Q_BUZ: 2N7002; SOT-23
R_BAT1: 100k_1%; R_0603_1608Metric
R_BAT2: 10k_1%; R_0603_1608Metric
R_LED1, R_LED2: 1k; R_0603_1608Metric
SW_BOOT: BOOT; SW_Push_1P1T_NO_CK_KMR2
SW_RST: RESET; SW_Push_1P1T_NO_CK_KMR2
U1: ESP32-WROOM-32E
U2: MPU-6000/6500; InvenSense_QFN-24_4x4mm_P0.5mm
U3: CH340C; SOIC-16_3.9x9.9mm_P1.27mm
U4: SY8120B_5V2A; SOT-23-6
U5: ME6211C33; SOT-23-5

Connections:
+3V3: C_3V3_1.1, C_3V3_2.1, J_I2C.1, J_IMU.1, J_IMU.8, U1.2, U2.8, U2.13, U5.5
+5V: C_OUT1.1, J_BUZ.1, J_GPS.1, J_RC.1, L1.1, L1.2, U4.6, U5.1
BUZZER: Q_BUZ.1, U1.12
BUZZER-: J_BUZ.2, Q_BUZ.3
CURR_ADC: J_ESC.7, U1.5
GND: C_3V3_1.2, C_3V3_2.2, C_IN1.2, C_OUT1.2, H1.1, H2.1, H3.1, H4.1, J_BAT.2, J_ESC.1, J_GPS.2, J_I2C.2, J_IMU.2, J_RC.2, Q_BUZ.2, R_BAT2.2, U1.1, U1.7, U1.14, U1.15, U1.16, U1.17, U1.18, U1.19, U1.20, U1.21, U1.22, U1.31, U1.37, U1.38, U1.39, U2.1, U2.11, U2.18, U4.2, U5.2
GYRO_INT: J_IMU.7, U1.6, U2.12
I2C_SCL: J_I2C.3, U1.35
I2C_SDA: J_I2C.4, U1.32
MOTOR_1: J_ESC.3, U1.11
MOTOR_2: J_ESC.4, U1.10
MOTOR_3: J_ESC.5, U1.25
MOTOR_4: J_ESC.6, U1.13
SPI_CS0: J_IMU.6, U1.28, U2.22
SPI_MISO: J_IMU.5, U1.30, U2.9
SPI_MOSI: J_IMU.4, U1.36, U2.24
SPI_SCK: J_IMU.3, U1.29, U2.23
UART1_RX: J_RC.3, U1.8
UART1_TX: J_RC.4, U1.9
UART2_RX: J_ESC.8, J_GPS.3, U1.26
UART2_TX: J_GPS.4, U1.27
VBAT: C_IN1.1, J_BAT.1, J_ESC.2, R_BAT1.1, U4.1
VBAT_ADC: R_BAT1.2, R_BAT2.1, U1.4
