Fizan-Feroz/ESP-FC-custom/(commit log)

2026-08-05 Add multi-channel PWM RX input, WS2812 LED strip and always-on WiFi telemetry
2026-08-05 Correct PWM receiver aux2 wiring to GPIO 14
2026-08-05 Add build and connection notes for this ESP32 build
2026-08-05 Fix WS2812 LED strip all-white bug by switching from I2S to RMT
2026-08-05 Add commercial-style LED strip status: blink patterns and ANGLE/ACRO mode colors
2026-08-05 Note led_mode reverting to POSITION after Configurator session
2026-08-05 LED: keep orientation colors when armed, slow fade in ACRO, non-blocking RMT write
2026-08-05 LED: fade ACRO strip fully to off for a more obvious breathing effect
2026-08-05 LED: racing colors, arm flash, disarm fade, ANGLE running-light front swipe
2026-08-05 LED: two-sided back-to-front swipe in ANGLE instead of orbiting band
2026-08-05 LED: ACRO swipe, ANGLE solid back + asymmetric front flash, fancy disarmed ping-pong
2026-08-05 LED: continuous ping-pong ACRO sweep, hue-cycling idle animation
2026-08-07 Gyro: gyro_dev boot selection, 500 Hz I2C rate, fast reinit recovery
2026-08-07 Airmode: configurable activate throttle with Storage migration
2026-08-07 LED: airmode strobe, throttle/angle-block indicators, smooth fixed-point sweep
2026-08-07 Fix PWM RX failsafe latch so input self-heals after a transient gap
2026-08-07 Add build notes: gyro_dev fast boot, RX failsafe latch, I2C 200 kHz config
2026-09-25 Mode debounce + AUX debug channels + LED probe
    - Actuator mode change debounce (25 frames ~50ms) to ignore single glitched frames
    - Input debug 4-7 expose AUX channels for troubleshooting
    - test/ledprobe FastLED hardware probe
2026-10-29 feat(hardware): add 30.5x30.5mm 4-layer ESP-FC flight controller PCB design, gerbers, and documentation
2026-10-29 docs: add comprehensive hardware guide, wiring map, and gerbers archive
2026-10-31 pcb v2: new schematic (ESP32-WROOM-32UE, LMR33630 2S-4S, ICM-42688-P, USB-C/CH340C auto-reset), ERC clean
2026-10-31 pcb v2: 36x36 4-layer outline, JLC rules, two-sided placement, GND/3V3/5V planes
2026-10-31 pcb v2: routed (In1 solid GND, In2 3V3 plane, GND stitching); DRC/ERC reports
2026-10-31 Niggas PCB Design is done
2026-11-04 fix(hardware): complete v2 PCB routing, upgrade TVS to SMAJ28A, export gerbers
